harryhecanada/mse450_project/User/main.h

/* Includes ------------------------------------------------------------------*/
#include "stm32f4xx.h"
#include "stm32f4_MPU6050.h"
#include "PID.h"
#include <stdio.h>
/* Exported functions ------------------------------------------------------- */
void Process_Data(void);
void Fail_Handler(void);
void Process_Hall(void);
