harryhecanada/mse450_project/(commit log)

2015-03-18 Adding TODO to code for thursday's lab
    use search to find TODO in code in main.c and stm32f4xx_it.c
2015-03-18 Updated the PWM code
    Maybe good enough for testing thursday
2015-03-19 Fixed code for lab tests
    asdfasdqw
    [main.c]
2015-03-19 Adding the ARM CMSIS DSP library
    Library contains PID controller functions we can study... or use
2015-03-20 3 Phase Sinewave PWM Complete
2015-03-20 Adding startup code for STM32F429
2015-03-25 TODO: Fix Hall Sensor
    XOR is not picking up certain signals... not sure why
    [main.c]
2015-03-25 Updated some stuff on motor speed control
2015-03-27 This should fix everything
    [main.c]
2015-04-02 FUCK YOU INTERNET THE TRUTH WAS IN THE WIRES
2015-04-08 Final Code
    Fixed bugs from code clean up.
    [main.c, main.h]
